rodpauloduran/MAARE-Avionics-System/water_rocket_avionics_bom.xlsx

Sheet: Parts & Costs
Water Pressure Rocket — Avionics Bill of Materials
Prices as shown in the shopping carts on 04 Aug 2026. Stores: Circuit Rocks (Manila) and Makerlab PH (Manila). Shipping and tax not included. Phase 1 = minimum viable flight computer; Phase 2 = full telemetry / research payload.
Category | Item | Store | SKU | Qty | Unit Price | Line Total | Phase | What it does | Why this part | Alternatives / notes | Product Link
Compute | Raspberry Pi Pico (with headers) | Makerlab | — | 1 | ₱459.00 | ₱459.00 | 1 | Flight computer. Runs the sensor loop, state machine and deployment logic. | 264 KB RAM holds the entire 10 s flight in memory, so nothing is written to flash during the 50 g boost. Dual core lets the radio run isolated from the timing-critical sensor loop. | RP2040-Zero (more GPIO, smaller); XIAO RP2040 (lightest). Rejected: ATmega328 Nano (2 KB RAM, cannot buffer a flight) and ESP32 (radio stack causes interrupt jitter). Plain Pico, not W — WiFi is dead weight in the nose and the CYW43 chip takes GP23/24/25/29. | Open product page (https://makerlab.ph/products/raspberry-pi-pico-rp2040-microcontroller-raspberry-pi-pico-w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)
Compute | Raspberry Pi Pico W (ground station) | Makerlab | MLE04027 | 1 | ₱590.00 | ₱590.00 | 2 | Ground station receiver. Takes the LoRa downlink and serves it to your phone over WiFi. | On the ground, mass and pin pressure don't apply, so the WiFi earns its keep: run a soft AP, connect your phone, watch live altitude with no laptop in the field. LoRa sits on SPI0 (GP16–19) so there is no clash with the CYW43 pins. | Heltec WiFi LoRa 32 / TTGO LoRa32 (~₱1,200–1,800) bundles ESP32 + SX1276 + OLED in one board and would replace this plus one RFM95W. NOTE: the with-headers variant (₱575) is sold out; ₱590 is the without-headers price. | Open product page (https://makerlab.ph/products/raspberry-pi-pico-rp2040-microcontroller-raspberry-pi-pico-w-copy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)
Sensor | GY-63 MS5611-01BA03 barometer | Circuit Rocks | AB034 | 1 | ₱421.00 | ₱421.00 | 1 | Primary altimeter and apogee detector. Peak-and-drop logic fires the parachute. | ~10 cm resolution at ~100 Hz. Its two error sources (dynamic pressure and inertial gradient) scale with velocity and acceleration, so both vanish at apogee — exactly where the reading matters. | BMP390 (~5 cm, 200 Hz) is marginally better. BMP280 (~1 m) is flyable with a widened threshold. MPL3115A2 rejected: max ~1–10 Hz gives only 3–30 samples on a 3 s ascent. | Open product page (https://circuit.rocks/products/gy-63-ms5611-01ba03-atmospheric-pressure-module?variant=45812624982305)
Sensor | Pololu MinIMU-9 v6 (LSM6DSO + LIS3MDL) | Circuit Rocks | POL2862 | 1 | ₱2238.00 | ₱2238.00 | 2 | Coast-phase acceleration, gyro attitude, magnetometer heading. Tilt-based apogee backup and flight-path reconstruction. | Gyros are the only source of orientation — no accelerometer can supply it. ±16 g gives fine resolution once boost forces are gone. Proper regulator, level shifting and decoupling, unlike clone boards. | HW-123 / MPU-6050 at ~₱150 is adequate for a 10 s flight and saves ~₱2,100. ICM-42688-P (±4000 dps) is the real fix if the airframe spins past the ±2000 dps ceiling. | Open product page (https://circuit.rocks/products/minimu-9-v6-gyro-accelerometer-and-compass-lsm6dso-and-lis3mdl-carrier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)
Sensor | Adafruit ADXL375 high-g accelerometer ±200 g | Circuit Rocks | 5374 | 1 | ₱2096.00 | ₱2096.00 | 2 | Boost-phase acceleration, launch detection, burnout timing. | The only sensor that does not saturate during the 0.2–0.4 s burn at 20–100 g. Everything else clips at ±16 g and records a flat plateau. | H3LIS331DL (±100/200/400 g) is cheaper with selectable range. Not required for flight 1 — the IMU still detects launch, it just clips. NOTE: ADXL345 is only ±16 g and cannot do this job. | Open product page (https://circuit.rocks/products/adxl375-high-g-accelerometer-200g-with-i2c-and-spi-stemma-qt-qwiic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)
Sensor | SparkFun GPS Breakout SAM-M8Q (u-blox) | Circuit Rocks | GPS-15210 | 1 | ₱2348.00 | ₱2348.00 | 2 | Landing coordinates. A recovery beacon, not a flight sensor — it will lose lock at launch and take 5–15 s to reacquire. | Integrated antenna with u-blox's own RF design removes the commonest silent failure mode. Multi-GNSS including QZSS, which covers the Philippines well. Backup battery gives fast hot starts between flights. | Adafruit Ultimate GPS (GPS-only, 34 s warm start, smaller board, no airborne dynamic model). ZOE-M8Q if the 40×40 mm footprint won't fit the nose cone. | Open product page (https://circuit.rocks/products/gps-breakout-chip-antenna-sam-m8q-sparkfun-force-density-level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)
Radio | Adafruit RFM95W LoRa Breakout 868/915 MHz | Makerlab | — | 2 | ₱1599.00 | ₱3198.00 | 2 | Live telemetry downlink plus post-landing position beacon. One unit flies, one is the ground station. | LoRa spread spectrum buys ~10–20 dB of link budget over FSK — decisive when the rocket lands in wet grass with its antenna horizontal. SX1276 tunes 862–1020 MHz, so frequency is a firmware choice. | RFM69HCW (FSK, ~500 m) if LoRa is out of stock — adequate at your ranges. RFM96W is 433 MHz and will NOT tune to 868 properly. See the Design Notes sheet before setting frequency. | Open product page (https://makerlab.ph/products/adafruit-rfm95w-lora-radio-transceiver-breakout-868-or-915-mhz-radiofruit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)
Recovery | MG90D metal-gear micro servo, 180°, 1.8 kg | Circuit Rocks | AF016 | 1 | ₱192.00 | ₱192.00 | 1 | Pulls the latch pin that releases the nose cone / parachute bay. | Positional (not continuous-rotation) so it moves to a commanded angle and holds. Metal gears survive the 50 g boost and hard landings where plastic gears strip. | SG90 (plastic gears, cheaper, less shock-tolerant). Nichrome burn-wire as an independent backup channel. AVOID the 360° MG90D — it takes speed commands, not angles. | Open product page (https://circuit.rocks/products/micro-servo-mg90d-180-deg-high-torque-metal-gear?variant=45812563247393)
Recovery | LS3040 piezo buzzer (4 kHz, 2 mA) | Makerlab | — | 1 | ₱49.00 | ₱49.00 | 1 | Audible locator on landing; arming and status confirmation on the pad. | 4 kHz sits near peak human hearing sensitivity. 2 mA draw means it can chirp for hours. The cheapest genuinely useful part on the board — it works when the radio doesn't. | Active buzzer module (2.3 kHz, 25 mA, onboard transistor). This unit is active, so no frequency sweep — use chirp patterns instead, which gives most of the localisation benefit. | Open product page (https://makerlab.ph/products/ls3040-piezo-electric-buzzer?variant=43321211748543)
Safety | Reed switch 2×14 mm normally-open (10 pcs) | Circuit Rocks | AL040 | 1 | ₱149.00 | ₱149.00 | 1 | Arming switch. Separates 'powered on' from 'deployment live'. | Sealed inside the airframe, actuated by a magnet from outside — no hole to admit water, nothing protruding to snap off. Prevents the servo firing while your hands are in the bay packing the chute. | Nylon screw switch (latching, visible armed state). Hall effect sensor (no moving parts, immune to vibration) if reeds prove fragile. Pack of 10 because the glass envelope cracks easily. | Open product page (https://circuit.rocks/products/reed-switch?variant=45812587102497)
Safety | Neodymium magnet N35 8×5 mm | Circuit Rocks | 2775 | 1 | ₱15.00 | ₱15.00 | 1 | Actuates the reed switch through the nose cone wall. | Comfortably strong enough to close a 14 mm reed at a few centimetres through plastic. Tape it in place to arm; peel it off to disarm on recovery. | Any N35+ neodymium of similar size. Keep it well away from the LIS3MDL magnetometer and the LiPo. | Open product page (https://circuit.rocks/products/magnet-neodymium-n35-ndfeb-circular-8x5mm?variant=45837630570785)
Power | PKCell 500 mAh LiPo 3.7 V (LP503035) | Makerlab | — | 1 | ₱200.00 | ₱200.00 | 1 | Powers the flight computer. Feeds Pico VSYS directly, no regulator needed. | ~5 h runtime at ~100 mA draw, and only 10.5 g. Integrated protection circuitry (over-charge, over-discharge, short). Genuine JST-PH connector. | Rejected: 2×18650 (~90 g, 30 h runtime, needs a buck converter) — 15× the energy at 12× the mass, and nose mass directly costs apogee. Hard-mount in foam; never let it float loose. | Open product page (https://makerlab.ph/products/lithium-ion-polymer-battery-3-7v-500mah?variant=42292840956095)
Power | Adafruit Micro LiPo Charger (MCP73831, micro-USB) | Circuit Rocks | 1904 | 1 | ₱662.00 | ₱662.00 | 1 | Charges the flight battery off any USB port. | Jumper-selectable 100/500 mA — set 500 mA for exactly 1 C on this cell, with no SMD resistor surgery. JST-PH connector already fitted, so it mates with the battery directly and there is no polarity risk. | TP4056 module (~₱60) is far cheaper but ships at 1 A and needs its R_prog resistor swapped from 1.2 kΩ to 2.4 kΩ, plus a soldered JST pigtail. Take the USB-C variant if stocked. | Open product page (https://circuit.rocks/products/micro-lipo-with-microusb-jack-usb-liion-or-lipoly-charger-v1-adafruit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)
Power | Capacitor electrolytic 220 µF 16 V (10 pcs) | Circuit Rocks | 2192 | 1 | ₱25.00 | ₱25.00 | 1 | Bulk decoupling at the servo power pins and at the LoRa module. | Servo inrush and LoRa transmit spikes are the classic cause of mysterious Pico resets and brownouts mid-flight. | Any 220–470 µF, ≥10 V. Also add 100 nF ceramics at each IC — not yet in either cart. | Open product page (https://circuit.rocks/products/capacitors-electrolytic-220uf-16v-pack-of-10?variant=45813709013281)
Power | Resistor 100 kΩ 5% 1/4 W (10 pcs) | Circuit Rocks | 2787 | 1 | ₱19.00 | ₱19.00 | 1 | 2:1 divider for battery voltage telemetry into GP26 (ADC). | Lets the LoRa packet report battery voltage, so you know the rocket is healthy before pressurising to 120 psi. | Any matched pair from 10 kΩ to 100 kΩ. Higher values draw less standby current. | Open product page (https://circuit.rocks/products/resistors-through-hole-100k-ohm-5-1-4w-pack-of-25?variant=45813708685601)
Build | FR4 universal protoboard, double-sided, 5×7 cm | Makerlab | — | 2 | ₱12.50 | ₱25.00 | 1 | Flight avionics stack — two decks joined by M3 nylon standoffs. | FR4 with plated-through holes, NOT phenolic/bakelite: phenolic pads lift off under 50 g shock. Two 5×7 decks fit a tapering nose cone far better than one 7×9 slab. | Lower deck: Pico, power, MOSFET, buzzer, servo header. Upper deck: sensors, GPS antenna facing up, LoRa antenna routed away from the GPS. | Open product page (https://makerlab.ph/products/fr4-universal-protoboard-pcb-double-sided?variant=43922032099519)
Build | FR4 universal protoboard, double-sided, 6×8 cm | Makerlab | — | 2 | ₱17.50 | ₱35.00 | 1 | Ground station board (receiver Pico + LoRa + optional OLED). | Mass and size are irrelevant on the ground, so the larger board gives easier layout. | Buy spares of both sizes — you will botch a layout at least once and want to redo it. | Open product page (https://makerlab.ph/products/fr4-universal-protoboard-pcb-double-sided?variant=43922032132287)
Build | Breadboard 400 tie-point | Circuit Rocks | AJ329 | 2 | ₱45.00 | ₱90.00 | 1 | Bench prototyping before anything is soldered. | One 400-point board holds a Pico and roughly one breakout. Five modules need two boards minimum. | An 830-point board is a better single purchase. Bring devices up ONE at a time and run an I2C scanner after each addition. | Open product page (https://circuit.rocks/products/breadboard-400-tie-point-interlocking-solderless-crystal?variant=45812706607393)
Build | 40-pin jumper wires, 20 cm male-male | Makerlab | — | 1 | ₱59.00 | ₱59.00 | 1 | Breadboard interconnects. | Standard prototyping consumable. | Solid-core 22 AWG hookup wire gives much cleaner, shorter runs — worth having for debugging. | Open product page (https://makerlab.ph/products/40-pin-10cm-jumper-wires?variant=43922163400895)
Build | 40-pin jumper wires, 20 cm male-female | Makerlab | — | 1 | ₱59.00 | ₱59.00 | 1 | Connecting modules that end up with female headers. | You need both genders; several breakouts ship headers loose so the choice is yours at soldering time. | — | Open product page (https://makerlab.ph/products/40-pin-10cm-jumper-wires?variant=43922163368127)
Power | Adafruit JST-PH switched 2-pin SMT right-angle (1863) | Circuit Rocks | 1863 | 1 | ₱215.00 | ₱215.00 | 1 | Battery connector AND power switch in one part. The LiPo plugs in; a slide switch cuts the output. | Solves two problems with one 2 g part and no hole in the airframe. Right-angle SMT keeps it low-profile on the lower deck, and the switch is inboard so nothing protrudes to snap off or admit water. | This replaces the need for a separate panel-mount power switch on the rocket. Alternative: no power switch at all — unplugging the JST is a perfectly good disconnect. | Open product page (https://circuit.rocks/products/jst-ph-switched-2-pin-smt-right-angle-breakout-board?variant=45813701017889)
Power | JST-PH 2.0 mm 2-pin female cable, 100 mm 26 AWG (10 pcs) | Makerlab | MLE07290 | 1 | ₱50.00 | ₱50.00 | 1 | Pigtails for wiring the battery into the flight board and for bench test leads. | 2.0 mm PH pitch — matches the PKCell battery and the Adafruit charger. 26 AWG is good for ~2 A, well past the 700 mA servo spike. | Do NOT buy JST RCY: it is 2.5 mm pitch and will not mate. Meter the pigtail against the battery before soldering — cheap cables occasionally have red/black swapped relative to the housing key. | Open product page (https://makerlab.ph/products/10-pcs-2-pin-jst-ph-female-connector-cable-100mm-26awg?variant=44313735725247)
Power | JST-PH 2.0 mm 2-pin angled shrouded male header (25 pcs) | Makerlab | MLE07362 | 1 | ₱99.00 | ₱99.00 | 1 | Board-mount sockets on the protoboard for the battery and any other detachable subassembly. | Right-angle keeps the connector flat against the deck instead of standing proud. Shrouded housing is polarised, so reverse-polarity insertion is physically impossible. | 25 pieces is far more than this build needs, but it makes every future project's battery connector free. | Open product page (https://makerlab.ph/products/25pcs-2-pin-angled-jst-ph-shrouded-male-connector-1?variant=44349686939839)
Build | Solder wire 0.6 mm 63/37 rosin core | Circuit Rocks | TOL-10242 | 1 | ₱271.00 | ₱271.00 | 1 | Soldering headers onto every breakout, plus all board wiring. | 0.6 mm is the right size for through-hole header work — feeds fast enough not to overheat pads, fine enough for occasional SMD. 63/37 is eutectic: no plastic phase, so fewer cold joints while learning. | 0.4 mm is SMD-focused and tedious on header pins; 1.0 mm bridges adjacent pins. Rejected both. Set the iron to ~330 °C. Buy a flux pen separately — it makes header joints dramatically easier. | Open product page (https://circuit.rocks/products/solder-wire-0-5mm?variant=45816082727201)
Build | Mini panel-mount SPDT toggle switch | Circuit Rocks | 3221 | 1 | ₱25.00 | ₱25.00 | 2 | Power switch for the ground station field box. | Latching SPDT, rated far beyond the ~100 mA load. On a table-mounted receiver its 5 g mass and 6 mm hole are irrelevant, and a physical toggle is what you want for power. | Deliberately NOT used on the rocket: 5 g, 33 mm long, and a 6 mm hole in an airframe that lands in wet grass. The switched JST breakout handles rocket power instead. | Open product page (https://circuit.rocks/products/toggle-switch-mini-panel-mount-spdt?variant=45812674593057)
Build | 40-pin jumper wires, 20 cm (third variant) | Makerlab | — | 1 | ₱59.00 | ₱59.00 | 1 | Third gender of jumper wire — likely female-female, confirm the variant at checkout. | Completes the set so any module-to-module or module-to-breadboard connection is possible without improvising. | Verify which gender this variant is before ordering; the product slug is shared across all three. | Open product page (https://makerlab.ph/products/40-pin-10cm-jumper-wires?variant=43922163335359)
 | GRAND TOTAL (both stores) |  |  |  |  | ₱13648.00
 | Circuit Rocks subtotal |  |  |  |  | ₱8766.00
 | Makerlab subtotal |  |  |  |  | ₱4882.00
 | Phase 1 subtotal — minimum viable flight computer |  |  |  |  | ₱3153.00
 | Phase 2 subtotal — GPS, IMU, high-g accel, LoRa pair |  |  |  |  | ₱10495.00
 | ASSUMPTION: the Makerlab cart displays a ₱25.00 / ₱35.00 unit price for the two protoboard sizes but a line total of ₱25.00 / ₱35.00 at qty 2. Unit price is entered here as ₱12.50 / ₱17.50 so the sheet reconciles with the ₱4,543.00 subtotal shown in the cart. Verify at checkout — this may be a cart display bug.
 | Blue cells are hardcoded inputs (prices copied from the carts, 04 Aug 2026). Black cells are formulas.

Sheet: Store Summary
Cost by Store
Calculated totals cross-checked against the subtotals displayed in each shopping cart.
Store | Location / terms | Units | Current Subtotal | Original Cart (04 Aug) | Added Since
Circuit Rocks (https://circuit.rocks/collections/all) | Manila — same-day ship before 4 PM; free shipping unlocked | 15 | ₱8766.00 | ₱8255.00 | ₱511.00
Makerlab (https://makerlab.ph/) | Makerlab Manila — tax included, shipping at checkout | 15 | ₱4882.00 | ₱4543.00 | ₱339.00
TOTAL |  | 30 | ₱13648.00 | ₱12798.00 | ₱850.00
'Original Cart (04 Aug)' is the subtotal each cart displayed before this revision (Circuit Rocks ₱8,255.00; Makerlab ₱4,543.00). 'Added Since' is the net change from dropping the second plain Pico and adding the Pico W, JST-PH connectors, switched battery breakout, SPDT toggle, solder wire and the third jumper variant. Neither figure includes shipping.

Sheet: Phasing
Build Phasing — Risk vs Cost
Water rocket recovery fails often on early flights. Flying a cheap configuration first proves the airframe, chute packing and deployment mechanism before expensive sensors are exposed to a hard landing.
Phase | Contents | Cost | % of Total | Rationale
Phase 1 | Pico ×2, MS5611 barometer, servo, buzzer, reed switch + magnet, LiPo + charger, passives, protoboard, breadboards, jumper wires | ₱3153.00 | 23.1% | Everything needed to log altitude and deploy a parachute reliably. Baro-primary apogee detection with a timer backup is competitive on a 3 s ascent. Fly this 3–4 times first.
Phase 2 | SAM-M8Q GPS, Pololu MinIMU-9 v6, ADXL375 high-g accelerometer, RFM95W LoRa ×2 | ₱10495.00 | 76.9% | Research payload: boost-phase g data, attitude reconstruction, live telemetry, GPS recovery. Add these to a vehicle whose recovery you already trust.
TOTAL |  | ₱13648.00 | 100.0%

Sheet: Still Needed
Not Yet in Either Cart
Estimated Philippine street prices entered as blue placeholders — replace with real quotes. Some of these are tools you may already own.
Item | Category | Est. Cost | Why it's needed
Multimeter | Tool | ₱500.00 | The single most important tool. Continuity checking alone saves hours; verify LiPo polarity before connecting anything.
Soldering iron, temperature-controlled | Tool | ₱1200.00 | Every breakout ships with headers loose in the bag. Soldering is not optional. Set to ~330 C for the 63/37 solder already in the cart.
Flux pen or paste | Tool | ₱200.00 | Rosin-core solder has flux inside, but extra flux on the pad is what makes header joints suddenly feel easy. Essential for any rework.
Solder wick, brass tip cleaner, helping hands | Tool | ₱400.00 | Rework and cleanup. You will make bad joints while learning.
USB logic analyzer, 8-channel clone (Sigrok/PulseView) | Tool | ₱450.00 | Highest-value cheap debug tool for I2C. When the bus goes silent you will see exactly why.
Data-capable USB cable for the Pico | Tool | ₱150.00 | Half the cables in any drawer are charge-only. This wastes a surprising amount of time.
100 nF ceramic capacitors (assortment) | Passive | ₱100.00 | Decoupling at every IC, alongside the 220 uF bulk caps already in the cart.
M3 nylon standoffs 15-20 mm + screws | Mechanical | ₱150.00 | Join the two avionics decks. Nylon not metal — lighter, and no accidental shorts.
EVA foam sheet / soft silicone potting | Mechanical | ₱200.00 | Shock isolation. A rigidly bolted PCB transmits the full 50 g spike; foam does not.
Piano wire 1 mm + servo horn hardware | Mechanical | ₱150.00 | The latch pin itself. Test the pull with the chute actually packed — friction is far higher than a bare bench test.
Solid-core hookup wire 22 AWG | Build | ₱200.00 | Clean short runs on the flight board. Jumper wires everywhere makes debugging miserable.
Antenna wire for 82 mm quarter-wave | Radio | ₱50.00 | 82 mm at 868 MHz (78 mm at 915). Cut accurately — wrong antenna length costs more range than any power setting.
SMA whip antenna + pigtail for ground station | Radio | ₱400.00 | A proper antenna on the receiver roughly doubles usable range for a few hundred pesos.
Conformal coating or clear nail polish | Mechanical | ₱150.00 | The rocket lands wet. Coat the board; leave the barometer port and exposed sensor dies uncovered.
LiPo safety bag or ceramic tile | Safety | ₱250.00 | Charge on a non-flammable surface, never unattended. Cheap insurance.
Gore-Tex or hydrophobic mesh scrap | Mechanical | ₱100.00 | Covers the static ports. A water droplet across a port gives wildly wrong pressure readings.
ESTIMATED ADDITIONAL SPEND |  | ₱4650.00
ASSUMPTION: every cost on this sheet is a rough estimate supplied as a placeholder, not a quote. They are shown in blue as hardcoded inputs — overwrite them with real prices.

Sheet: Design Notes
Key Design Decisions & Regulatory Notes
The reasoning behind the parts chosen, and the constraints that drove them.
Topic | Decision | Reasoning
Apogee detection | Barometer peak-and-drop is primary. Timer is backup. IMU tilt is an inhibit only. | Baro differentiates a measured position — error is bounded and never accumulates. An IMU integrates acceleration — error is unbounded, grows from a clipped boost, and is undetectable without an external reference. Baro error sources (dynamic pressure ~ v², inertial gradient ~ a) both vanish at apogee.
Detection latency | MS5611 at ~10 cm noise needs ~30 cm of drop ≈ 0.25 s past apogee. A BMP280 at ~1 m would need ~0.7 s. | Altitude near apogee follows h = h_max − ½gt², so the curve is flat there and sensor noise translates directly into detection delay. This is the entire argument for the MS5611 over the cheaper BMP280.
Deployment lockout | Inhibit deployment until boost has ended plus ~0.5 s. Latch the fire flag so it cannot retrigger. | Prevents a boost-phase pressure transient firing the chute at 70 m/s. Bias every threshold toward late — late deployment costs some data, early deployment shreds the parachute.
Static ports | 3–4 holes of ~1 mm, evenly spaced, at least one body-diameter aft of the nose shoulder. | Uneven or badly placed ports cause pressure asymmetry that reads as phantom altitude. Port quality dominates sensor noise if you get it wrong. Size for lag too — keep the bay time constant under ~50 ms.
I2C bus | MS5611 (0x77), LSM6DSO (0x6A), LIS3MDL (0x1C/0x1E), ADXL375 (0x53), GPS (0x42) — all on two wires. | No address conflicts. Run at 400 kHz with short traces. Watch for clone boards carrying 2.2 kΩ pull-ups; three in parallel is too strong and the bus will misbehave.
Firmware architecture | Core 0: 500 Hz sensor loop and state machine, buffered in RAM. Core 1: LoRa TX, GPS parsing, flash dump after landing. | No flash writes during the 50 g boost — the commonest way to lose a flight's data. If the radio stalls, core 1 stalls and core 0 never notices. Deployment logic must never depend on the link.
Filtering | Log raw counts in flight. Do Kalman fusion offline in Python. | Iterate in seconds instead of reflashing and relaunching. Port the filter onboard only once it agrees with raw data across a dozen flights.
LoRa frequency — CHECK THIS | Configure to 868–870 MHz at +14 dBm, NOT the US 915 default. Verify current NTC rules yourself before flying. | NTC MC 03-06-2017 lists PH non-specific SRD / telemetry bands as 868.000–868.600, 868.700–869.200 and 869.300–869.700 (25 mW erp), plus 869.700–870.000 (5 mW erp). Whether 915–918 (AS923-3) is permitted is actively disputed in the LoRa community. NTC MC 004-06-2026 amended SRD parameters again in June 2026 — check for anything newer.
LoRa duty cycle | EU-style bands typically carry a 1% duty cycle limit. | At SF7/BW250 a 16-byte packet is ~10 ms airtime, so 20 Hz telemetry is ~20% duty. Either slow the live stream toward ~1 Hz, or accept the tradeoff knowingly. A landed beacon at one packet per 5 s is comfortably within limits.
Mass budget | ~80 g total avionics, all of it in the nose cone. | A water rocket has fixed impulse from its pressure vessel, so every gram of dry mass directly costs apogee. Nose mass also shifts CG forward, requiring larger fins to keep CP aft of it.
Arming sequence | Battery in → pack chute → seat cone → mount on launcher → ARM with magnet → step back → pressurise. | Arming is the last action, performed from outside a sealed airframe. Disarming is the first action on recovery, before touching the rocket. A buzzer chirp and a state field in the LoRa packet confirm it from 10 m away.
