rodpauloduran/MAARE-Avionics-System/CHANGELOG.md

# Changelog

Notable changes to the MAARE avionics system, newest first.

Format loosely follows [Keep a Changelog](https://keepachangelog.com/).

---

## [0.3.2] — 2026-09-13

Four things the v0.3.1 notes listed as unresolved, the outdoor GPS test that
had been open since v0.2.0, and three of the four long-standing bench items.

### Added

- **`!hgcal` — a six-position ADXL375 zero-g offset trim.** The part has
  hardware offset registers (`OFSX`/`OFSY`/`OFSZ`) applied before the data
  reaches the output registers; the Adafruit library does not expose them but
  does expose `writeRegister()`. Rest the board on each of its six faces and
  capture one at a time, and gravity cancels out of each axis's up/down
  average, leaving the bias. `apply` **adds** its correction to whatever is
  already in the register, having measured the residual with that value
  applied — so the datasheet's 196 mg/LSB is a starting guess rather than a
  dependency, and a second pass squares away however wrong it is. Not
  persistent: it prints three `HG_TRIM_*` constants to paste and re-flash,
  applied and read back at boot like every other setting. Drivable from a phone
  (`hgcal zup`), since the calibration wants both hands on the board.
- **The I²C scan measures the `0x7E` phantom instead of mentioning it.** Every
  address is probed eight times at 100 kHz and again at 400 kHz, with the hit
  rate printed beside it. 8/8 at both speeds is a device; intermittent, or
  present only at 400 kHz, is the master reading a floating line as an
  acknowledgement — and the scan now says so, along with what to change. No
  firmware can repair a marginal bus; it can stop reporting one pass as a fact.
  Bus speed is explicit (`I2C_HZ`) rather than the core's implicit default.
- **Latch feedback, the firmware half.** Set `LATCH_SWITCH_PIN` and every
  commanded move is confirmed against the switch after the settle window, with
  a failure printing `*** LATCH DID NOT RELEASE ***` and sounding the alarm.
  The sensed state rides in telemetry as a new `lsw` field — the only measured
  field in that line. The polarity is deliberate: closed to ground when
  released, pulled up, so a broken wire reports a fire that did not happen
  rather than certifying one that did.

### Changed

- **Nothing claims the latch fired when all it knows is that it asked.** With
  no switch fitted the board logs `SERVO FIRE COMMANDED ... (no feedback - not
  confirmed)` and the viewer reads `latch: FIRE COMMANDED (unconfirmed)`. With
  one fitted it reads `RELEASE CONFIRMED`, or `FIRED BUT STILL ENGAGED`.
- **The viewer says less.** The deployment panel's standing explanation — why
  the harness is not the flight path, the section references, the argument for
  keeping deployment on the board — is eleven lines shorter and now carries
  only what changes an action: keep hands clear while ARMED, and arming lapses
  3 s after the page stops sending heartbeats. Tooltips, the trajectory legend
  and the connection banners are trimmed the same way. The reasoning was
  already in the documentation, which is where it belongs.

### Fixed

- **The ground station now forwards every frame, once, instead of resending
  the latest one on a timer.** Each frame carries a sequence number and each
  connected browser tracks which one it has been sent — the same rule board
  messages already used. Before this, a stream slept one frame period and sent
  whatever `latest` held, so delivery was capped at the station's own loop
  period (`FRAME_DT` plus the time to write) and the frames produced in between
  were never sent at all: a 25 Hz board arrived at the 23 Hz visible in the
  v0.3.1 screenshots, and a 50 Hz radio would have been halved. A browser that
  cannot keep up still drops frames rather than queueing them — it is sent the
  frame that stands now, never a backlog.
- **The 5-second diagnostics summary no longer floods a phone's console.** Its
  GPS line went through `Out`, which tees to the wired link, so with no USB
  host attached the board stayed in table mode and pushed one of these to every
  phone every 5 seconds, burying the acknowledgements and refusals that are the
  console's job. `printGpsStatus()` now takes its destination from the caller:
  the link for `g` and `!g`, which someone asked for; USB only for the summary,
  which nobody did.
- **The stage label no longer runs underneath the stage tabs on a phone.** The
  label and the tabs were independent overlays pinned to opposite corners of
  the same strip, which collides as soon as the label is long and the screen is
  narrow — `Trajectory — altitude measured, horizontal from GPS` sat directly
  under the tab row. They now share one flex container: side by side with room,
  stacked when not, tabs on top.
- **Deployment condition rows no longer come apart when they wrap.** Two 104 px
  value spans and a 74 px number input cannot share a 360 px screen, so the
  controls spilled one per line and the remove button ended up alone on a row
  of its own. Narrow screens now lay each row out as a grid with a named place
  for every control.
- **Constants wrapped over two lines were silently dropped from the test
  extract**, which surfaced as the ground-station model failing to compile
  rather than as anything to do with line length. The extractor now carries
  continuation lines with the assignment that opens them.

### Confirmed on hardware

- **Commands from a phone act on the board.** The one thing v0.3.1 shipped
  without evidence for.
- **The GPS, outdoors.** 12 satellites at ±2.5 m, tracking a path walked on
  foot 245 m from the pad datum — against the 5 satellites and 238 m wander
  that an indoor sky view gave, and matching what §4.5 predicted. Every fix in
  that track cleared the ±10 m pad-datum gate, so the path drew solid for its
  whole length. The receiver, its antenna and the configuration are sound; the
  remaining error is metres, which is why GPS stays a recovery aid and never a
  deployment input.

- **Stream forwarding is now testable.** The rule lives in a `StreamCursor`
  object rather than inline in `serve_stream`, so `run_checks.py` can drive it
  with a fake clock and no socket: every frame forwarded once per browser, the
  current frame rather than a backlog to a slow client, independent clients,
  keep-alive comments paced rather than one per poll, and the first frame after
  a silence sent even when identical to the last one before it. The old
  behaviour was wrong in a way nothing could see, because there was nothing to
  call. Mutation-tested — restoring either the v0.3.1 resend or a queueing
  variant fails the run.

### Docs

- **Outdoor GPS screenshots** in the README, §4.5 and the status report; the
  open item asking for them is closed, and the indoor-only qualification is
  gone from the design doc's summary.

### Known, unresolved

The three bench items above all now have their firmware half; what is left is
bench work and one part.

- **`!hgcal` has not been run on the hardware.** Until it is and the three
  `HG_TRIM_*` constants are committed, the ADXL375 still reads 0.73 g at rest
  against the LSM6's 1.01 g.
- **The `0x7E` phantom has not been re-measured** with the new two-speed scan,
  so whether it is intermittent, rise-time dependent, or stubbornly 8/8 at both
  speeds is still unknown.
- **No limit switch is fitted**, so no latch movement is confirmed by anything
  physical. The firmware is waiting on `LATCH_SWITCH_PIN`.
- **The latch-feedback and calibration paths are untested on hardware.**
  Everything compiles and the offset arithmetic is straightforward, but no
  switch has ever closed and no trim register has ever been written outside a
  compiler.
- **The servo stays on VBUS** by choice — the power bank lives on the flight
  Pico, so VBUS is present.
- **The ground station stays on its default Wi-Fi password** by choice; it is
  published in this repository, and that network can arm the latch.

## [0.3.1] — 2026-09-11

### Added

- **Wired UART downlink, as a stand-in for the radio** while the antenna
  pigtails and connectors are not on hand. The flight computer writes the §6.6
  line to `Serial1` (GP0) every tick, whatever its USB port is doing; the
  ground station reads GP1 into the same producer slot the radio will use. It
  tests everything downstream of the receiver and nothing about the receiver.
  **Transmit-only from the flight side**, deliberately: the real link is
  fire-and-forget, and a wire that could arm the latch from the ground is not a
  decision to make by accident in a test rig.
- **Explicit telemetry sources on the ground station** — `uart` (default) or a
  synthetic profile — with **no fallback** from a dead wire to synthetic data.
  In `uart` mode the synthetic model does not run, so a quiet wire goes stale
  instead of being papered over. `/health` reports the source and link counters
  in every mode.
- **Frame validation and line reassembly on the station** (`feed()`,
  `accept_line()`): partial lines, board text, undecodable bytes and wrong
  field counts are counted and dropped before they reach a browser.

- **Full control from a phone** — board commands and the whole deployment
  panel, served by the ground station and relayed up the wired link. The wire
  was built transmit-only first so that ground control of the latch could not
  arrive by accident; this adds it on purpose, with the constraints that make
  it tolerable:
  - `/cmd` **rebuilds every command from an allowlist** rather than forwarding
    it; unknown words, extra arguments, out-of-range numbers and a second
    command smuggled after an encoded newline are refused.
  - The flight computer accepts **framed `!word` lines only** from the wire,
    never a bare byte — so noise on an unplugged RX pin cannot trigger `z` or
    `b`. `v`, `c` and `h` have no framed form and cannot be sent up at all.
    Over-long lines are discarded rather than acted on as a truncated prefix.
  - **Board commands are refused unless the wire is the selected source**, at
    the station (`409`) and in the page (buttons greyed, an armed latch told to
    safe), because a real latch beside a synthetic display is a display lying.
  - **The deadman is unchanged**: heartbeats come from the page, so locking the
    phone or switching apps disarms the latch within 3 s.
- **Board messages reach the phone.** Everything the flight computer says about
  its state — acknowledgements, refusals, the boot banner, GPS status — is
  teed to the wire as `M,` lines and fanned out to every phone's console as SSE
  `msg` events, with recent ones replayed to a phone that joins late.
- **`station_secret.py`** for the Wi-Fi password, git-ignored. Joining the
  network now means being able to arm the latch, and the default is public; the
  station warns at boot and in `/health` while it is still in use.
- **`tools/checks/viewer_net_checks.js`** — the viewer loaded as the station
  serves it, over HTTP with fake `fetch` and `EventSource`, checking command
  routing, refusals, board messages, and that controls die and an armed latch
  is safed when the source goes synthetic. Mutation-tested: removing either the
  source guard or the network routing makes it fail.

### Fixed

- **The viewer read `Live` the moment the SSE connection opened**, before any
  data. With the wire as the default source and nothing on it, that meant LIVE
  over a motionless model — the exact confusion the staleness work exists to
  prevent. `Live` now waits for the first real frame.
- **The source selector and hint asserted a source instead of reading one.**
  The selector always opened on "Bench wobble" and the hint always said
  "synthetic". Both now come from `/health`.
- **§6.5's diagram had the RFM95W talking to the Pico W over UART.** It is an
  SPI transceiver. Corrected, along with the open item that described the
  eventual radio producer as a UART reader.
- The ground station README's copy of the wire format was missing v0.3's
  `srv,srvus` fields.

### Notes

- **`Serial1.write()` blocks on this core** (`mbed::UnbufferedSerial`,
  busy-waiting on `writeable()` past the 32-byte FIFO). The link runs at
  **460800** baud so a ~100-byte line costs the flight loop ~1.5 ms rather than
  ~6 ms at 115200.
- **Wiring:** GP0↔GP1 both ways and GND→GND between the boards. Power either
  each board from its own USB, or one power bank with VSYS joined to VSYS —
  and in the latter case **move the servo's V+ from VBUS to VSYS**, because
  VBUS only exists on a board whose own USB is plugged in. 3V3_EN is the
  regulator's enable input, not a supply — tying it anywhere powers nothing and
  can switch a board off.

### Known, unresolved

- **Commands sent from a phone have not yet been seen to act on the board.**
  The phone screenshots confirm the downlink on hardware: live telemetry at
  23 Hz on the board's clock with zero bad lines, the source read correctly from
  the station, the latch state reported by the board, and the board's messages
  reaching the phone's console. They do not show an `arm` or `fire` from the
  phone producing `SERVO ARMED` or moving the horn.
- **The station forwards at most its own loop rate, not every frame.** It
  resends "the latest frame" on a fixed timer rather than forwarding each new
  one, so its loop period — `FRAME_DT` plus the time to write — caps delivery,
  and frames the board produced in between are never sent. The 23 Hz in the
  phone screenshot is that cap showing. The fix is to forward each new frame
  once, by sequence number, the way board messages already are.
- **Phone layout:** the stage label runs underneath the stage tabs on a narrow
  screen, and a deployment condition row wraps so its `×` button stretches the
  full width.
- **The phone console fills with a GPS line every 5 s** when the flight
  computer has no USB host. With nobody on its USB port it stays in table mode,
  and its 5-second summary's GPS status is teed to the wire along with the
  messages that matter. The summary should go to USB only.

### Docs

- **Phone screenshots and bench photographs of the wired rig**, in the
  README, §6.5, the hardware reference and the ground station README.
- **Photographs refreshed for v0.3**, and a new `viewer-trajectory.png`. The
  attitude screenshot now shows the deployment panel and serial monitor
  expanded, with the board's own log of a fire; the boot output shows the buzzer
  and servo latch announcing themselves silent and safe; the bench photos show
  the MG90D, the LS3040 and an RFM95W breakout alongside the sensors.
- **Captions rewritten to match**, because every one quoted figures from the
  screenshot it replaced. `bench-stack-2` moved from the §4.1 address map to
  the §8.1 latch section, since it now shows the servo and buzzer rather than
  the sensors, and `bench-stack-1` took its place in §4.1.
- **Release-note images pinned to their tags.** The v0.2.0 and v0.2.1 notes
  embedded their screenshots from `main`, so refreshing the photos silently
  changed what those older release pages showed — the v0.2.1 page would have
  displayed a v0.3 interface. Each now points at the image as it was at its own
  tag.

---

## [0.3.0] — 2026-09-11

### Added

**MG90D servo latch on GP6, with a configurable trigger harness in the viewer.**

- **Firmware.** The latch is driven through the **Servo** library. New `!`
  prefixed line commands carry the values a single character cannot:
  `!arm`, `!safe`, `!fire`, `!latch`, `!us <n>`, `!pos <a> <b>`, `!srv`, `!hb`.
  The existing single-character commands are untouched and still dispatch on
  arrival, so a truncated line can never be mistaken for one.
- **Wire format** gained `srv` and `srvus` — appended, so 8/9-field parsers are
  still unaffected. The viewer shows the **board's** view of the latch, not its
  own belief; if the two disagree, that is the thing worth seeing.
- **Viewer panel** (collapsed by default, because it is an actuator control):
  arm/safe, manual fire and re-latch, endpoint calibration in microseconds, and
  an editable condition list — altitude, drop below peak, vertical velocity,
  tilt, |a|, high-g, rate magnitude, satellites, time since arm — each with a
  comparator and threshold, combined with **all** or **any**, and a **sustain
  window** the conditions must hold before firing. Settings persist across
  reloads. **Export** emits the tuned values as C constants.

**Interlocks**, in the order they matter: the pin is **not driven at boot**
(period set, pulse width zero); nothing moves while disarmed, and arming does
not itself move anything; a **3 s deadman on the board** disarms if the host
goes quiet; firing latches and auto-safes, and the viewer also disarms on
telemetry staleness or a closed port.

> **This is a bench harness, not the flight deployment path.** Conditions are
> evaluated in the browser and a fire command is sent down the wire — the right
> shape for a bench rig, and exactly the wrong shape for flight, where
> deployment must live in the board's state machine and never depend on a link
> (§2.3, §5.4). The harness produces *numbers*; those are what get compiled
> into the flight firmware.

- **LS3040 buzzer on GP7**, with non-blocking pattern playback — chirp, double,
  locator, alarm — selectable from the viewer, plus `!beep <hz> <ms>` for a
  one-shot. Arming the latch chirps and firing it double-beeps, which is
  §8.5's arming confirmation made audible. The board owns the timing, so a
  backgrounded browser tab cannot silence the locator.
- **Pin map reconciled again:** §9.1 specified the buzzer on GP13; it is on
  **GP7**. GP13 returns to the free list.

### Fixed

- **`tone()` leaks on this core, so the buzzer does not use it.**
  `Tone::stop()` nulls the `DigitalOut` *pointer* instead of writing the pin
  low, so `delete pin` frees nothing and every call leaks one `DigitalOut` —
  and the pin can be left HIGH, putting DC across a piezo after the beep.
  The buzzer drives a `DigitalOut` from a `Ticker` directly, allocated once.
- **Fire, and every condition-triggered fire, did nothing** — while `Go
  latched`, `Go released` and `Re-latch` all worked. The viewer sends `!fire`
  and then `!safe` back to back, as an interlock against a test rig staying hot.
  But `!safe` detached the servo a millisecond after `!fire` wrote the released
  position, cutting the pulse train before the horn could travel. The commands
  that worked were exactly the ones that leave the servo attached. Fixed on the
  board: safe refuses new motion immediately, but lets an already-commanded
  move finish over an **800 ms settle window** before stopping the pulse train.
  The interlock had been defeating the action it guarded.
- **The viewer no longer fires into a latch the board reports as already
  fired.** The board keeps `fired` latched until an explicit re-latch, as with
  `deployFired` in §5.4, so a second fire only earned a silent refusal. The
  condition engine now holds off, and the verdict says to re-latch first.
- **The servo did not move — because the servo was faulty.** A replacement
  moved under both a raw bit-bang and the Servo library, on VBUS, on the first
  try. Along the way the latch moved from `mbed::PwmOut` to the **Servo**
  library, which is confirmed working and stays. Attach/detach now serve as the
  arm/safe states, a stronger guarantee than a zero pulse width: detached, no
  pulse train exists at all.

  **Withdrawn:** an earlier entry here claimed `PwmOut` "compiles on this core
  and does not drive the pin", and cited the Servo library and `tone()` both
  avoiding it as evidence. Neither holds. `PwmOut` was only ever tried against
  the faulty servo, so it is *untested*; and a library's choice of mechanism is
  not evidence about a peripheral — software timing works on any pin, which is
  reason enough. Kept on the record rather than deleted, because a dead
  actuator making working firmware look broken is exactly the kind of silent
  failure this project exists to catch, and it caught this one late.
- **Added `servo_smoke/`** — one pin, one servo, no sensors or logic — so a
  stationary latch can be separated into firmware versus wiring and power in a
  single flash.
- **The design document claimed the Mbed core bundles a Servo library. It does
  not.** Verified against core 4.6.0, whose entire bundled set is MRI, PDM, SPI,
  Scheduler, ThreadDebug, USBHID, USBMSD and Wire. Corrected in §9.2 and the
  hardware reference, with the Library Manager install documented in its place.
- **Pin map reconciled to as-built.** §9.1 specified the servo on GP15; it is on
  **GP6**. Both documents now say GP6, and GP15 returns to the free list.

### Known, unresolved

- **The Fire path has not been confirmed on hardware.** The early-detach bug is
  fixed and the firmware compiles; the viewer's firing logic passes the
  headless checks. But the servo has not yet been *seen* to swing on `Fire` or
  on a condition-triggered fire since the fix. `Go latched`, `Go released` and
  `Re-latch` are confirmed. Treat conditional firing as unverified until it has
  been watched.
- **`mbed::PwmOut` is untested on this core**, not known-broken — see above.
- **VBUS is marginal for this servo on paper**, though it works in practice:
  USB 5 V behind a Schottky is roughly 4.7 V, against an MG90D specified from
  4.8 V, and a USB port current-limits near the servo's ~700 mA stall. Fine for
  an unloaded bench latch; re-check under a packed chute, and give it its own
  supply for flight.
- **A servo has no readback, and this project's standing rule cannot be applied
  to it.** `srvus` is what was *commanded*, never what the horn did — a stalled,
  stripped or unpowered servo reports exactly the same as a healthy one. The
  honest fix is mechanical: a limit or reed switch confirming the pin withdrew.
  Until then, "fired" means "commanded to fire".
- The latch has not been run on its own supply with the 220 µF fitted.

---

## [0.2.1] — 2026-09-09

### Added

- **`Fix gate` toggle** beside `Smoothing`. The pad datum is normally taken
  only from a fix that clears a quality bar (≥6 satellites, hAcc ≤10 m); this
  turns that off so any 2D fix will do — useful on a bench, where the bar is a
  launch-site bar the receiver rarely clears.
  Confidence and policy are kept apart: a weak fix accepted with the gate off
  is **still drawn faded and still counted low-confidence**. Turning the gate
  off permits a datum; it does not make the fix accurate. It also does not move
  an existing datum — that is what `Set pad` is for.
- **Serial monitor in the page.** The footer only ever showed the latest line,
  so boot output and `g` replies scrolled past at 25 Hz and the only way to
  read them was to disconnect and open the Arduino Serial Monitor — which
  means giving up the port, and therefore the live view. The console is
  collapsed by default, excludes telemetry frames unless asked, preserves the
  blank lines the boot output uses as structure, and sticks to the bottom only
  when the reader is already there. Read-only: `c` and `h` would corrupt the
  stream the page is parsing, so there is no free-text field to fire them from.

### Fixed

- **The trajectory legend overlapped the stage hint.** Both are anchored to the
  bottom edge of the stage — the hint is absolutely positioned across its full
  width — so the legend text and the "close the Arduino Serial Monitor first"
  overlay drew straight through each other, and the legend got worse as it grew
  lines. The hint is now hidden on the trajectory tab (it is about connecting
  and streaming, not the path) and restored on the attitude tab, and the legend
  draws its own backing panel so the ground grid cannot muddy it either. The
  drag-to-orbit affordance is dropped on a canvas too narrow to hold it clear
  of the legend block — on a small screen the numbers matter more than the hint.

- **A missing `hAcc` blocked the pad datum forever.** The gate hard-required
  the field, contradicting the rule that appended fields are optional (§6.6).
  Any board on firmware older than that field could never establish a datum,
  and the only symptom was a **purely vertical trajectory** with nothing on
  screen explaining why. Where `hAcc` is absent the gate now falls back to
  satellite count alone.

### Test

`tools/checks` gained cases for all three: the gate as a policy toggle that
does not launder a weak fix, a legacy 14-field frame still datuming on
satellite count, and the console's filtering, blank-line handling and cap.

### Docs

`docs/images/viewer-attitude.png` refreshed to show the release as built — the
`Fix gate` toggle, the `ACCURACY` readout and the collapsed serial monitor.
Captions in the README and §6.7 updated to match its figures, since a caption
that misdescribes its own image is worse than none.

---

## [0.2.0] — 2026-09-09

### Added

**ADXL375 high-g accelerometer and SAM-M8Q GPS are wired onto the I²C bus and
driven by `rocket_diagnostics/`.** All four sensors specified in §3.1 are now
physically present on the flight computer.

- **High-g column** in the diagnostics table, plus a peak tracker and a rest
  check. Absent hardware reads `---` rather than a fabricated `0`.
- **GPS status** — fix type, satellite count, coordinates and MSL altitude —
  printed in the 5-second summary and on demand with a new `g` command.
  Distinguishes *never acquired* from *acquired and lost*, because those point
  at different faults (sky view versus antenna or power).
- **Config readback extended to both new parts**, applying the rule §4.3
  already imposes on the IMU: the ADXL375 output data rate is decoded from
  `BW_RATE`, and the GPS dynamic model and navigation rate are read back from
  the module. Both are printed at boot, so a write that silently failed shows
  up as a wrong *printed* value.
- **Graceful degradation.** Neither new part is fatal if absent — only the
  barometer and IMU halt the sketch, because every other displayed number is
  derived from them.
- CSV mode gained a `highg_g` column.

**High-g and GPS reach the viewer, and there is a trajectory view.**

- **Wire format extended** (§6.6) by *appending* six fields, so any parser
  reading only the first eight or nine is unaffected:
  `V,ax,ay,az,gx,gy,gz,alt,vel,millis,hg,fix,sats,lat,lon,hacc`.
  `hg` and `fix` use **−1** for "part not fitted" — deliberately distinct from
  a zero reading, since 0.00 g is legal in freefall, fix type 0 is a legal
  "no fix", and 0,0 is a real position in the Gulf of Guinea.
- **High-g and GPS readouts** in the viewer: magnitude and peak, fix type,
  satellite count, position, and distance from the pad.
- **Trajectory tab** — the flown path in 3D over a metric ground grid, with a
  drag-to-orbit camera that auto-frames the data. **Only altitude is
  measured.** Horizontal comes from the GPS, which is blind through the whole
  flight, so unlocked segments are drawn dashed and red with the horizontal
  frozen at the last fix — never interpolated. A smooth arc through that gap
  would be an invention.
- **Path sampling throttles on the board's clock**, not on arrival time. Both
  transports deliver in bursts; throttling on arrival collapses a burst into a
  single point and samples the path unevenly. This is the same argument that
  put `millis()` in the format in the first place.
- **Board command buttons** — `Zero baro`, `Gyro bias`, `Reset peaks`,
  `GPS status`. Serial-only, and hidden in network mode: SSE is one-way, so a
  page served by the ground station has no back-channel to the flight computer.
  `c` and `h` are deliberately not exposed — both corrupt the stream the page
  is reading. Zeroing and bias blocking the sketch for a second or more
  suppresses the staleness flag for the duration, so it does not cry outage
  about a pause the operator asked for.
- **Ground station producer** emits the same fourteen fields, including a
  synthetic GNSS that **drops lock from launch until a few seconds past
  apogee** and reacquires drifted downwind. Without that, the trajectory gap
  path would go untested until a real flight.

**GPS position is now qualified, not just reported.** Found on the bench: a
stationary board holding a **3D fix on 5 satellites** sat **238 m** from where
it first locked, with the fix type reading `3D` the whole time. Two separate
problems, one of them ours.

- **`hacc` carried in telemetry** — the receiver's own horizontal accuracy
  estimate, already present in the NAV-PVT message it sends anyway
  (`getHorizontalAccEst()`), so it costs nothing. Shown in the viewer and in
  the sketch's `g` output, which now also warns when satellites drop below 6.
  A position with no accuracy beside it cannot be argued with.
- **The pad datum is gated.** It was taken from the *first* locked fix — the
  worst one of any session, straight out of a cold start with the fewest
  satellites and the worst geometry. Every distance was then measured from it,
  and every later and better fix appeared to *move*. The datum is now accepted
  only from a fix the receiver vouches for (**≥ 6 satellites, `hAcc` ≤ 10 m**);
  until one arrives the display reads `no pad datum` instead of a fabricated
  distance from a bad origin.
- **`Set pad` button** re-datums on the next fix that clears the same bar, and
  discards points recorded against the old datum — they live in the old frame
  and would draw a step the vehicle never took.
- **Low-confidence fixes are drawn faded** rather than dropped or drawn at full
  strength. Dropping them would hide that the vehicle was somewhere; drawing
  them normally would overstate how well we know where.

Note the drift being *along one axis* was not a bug: with five satellites in
one patch of sky the error ellipsoid is long and thin, so a poor fix wanders in
a line rather than a blob.

**Telemetry staleness is now visible, end to end.** Previously "radio silent"
and "vehicle sitting perfectly still" produced identical displays — recorded in
the design document as a safety-relevant display defect rather than a nicety.

- **Viewer** (all three builds): a gap of more than 1.5 s — about 37 missed
  frames at 25 Hz — turns the status dot amber, counts the age of the last
  frame, and dims the numeric readouts. It runs independently of each
  transport's own error handling, because neither catches the case that
  matters: an SSE connection stays open while the ground station has nothing to
  forward, and a quiet serial port raises nothing.
- **Ground station**: `/stream` now stops emitting data frames when its source
  has been quiet for more than 1 s, sending SSE comment lines instead so the
  connection and its retry timer stay alive. This half is not optional. The
  stream previously re-sent the last frame forever, which would have made the
  viewer's timeout useless once the radio is real — frames would keep arriving
  on time, all saying the same thing. `/health` also reports `stale` and
  `source_age_ms`.
- New producers must call `tel.set_line()` rather than assigning `tel.latest`,
  so the freshness timestamp cannot be forgotten. The radio-hook example in the
  ground station README is updated accordingly.

**Photographs and screenshots added** under `docs/images/`, referenced from the
README, design document, hardware reference and status report: the viewer
running live on hardware, the diagnostics boot output, and two angles of the
breadboard bench stack. `.gitattributes` gained binary rules for image formats
— `* text=auto` would otherwise apply line-ending heuristics to them.

**All four sensors are now confirmed on hardware.** The boot output shows every
device answering on the bus and every configurable one reporting its settings
back: `CTRL1_XL = 0x50`, `CTRL2_G = 0x58`, `BW_RATE = 0xD` → 800 Hz, and the
GPS `airborne <1g  OK` at 5 Hz. §13.1 steps 5 and 6 are closed, with two
qualifications recorded below.

### Fixed

- **The high-g rest check called a healthy sensor faulty.** Its ±0.15 g
  tolerance was sized against quantisation (~20 counts per g) and ignored the
  much larger effect: the ADXL375's **zero-g offset is specified in whole g,
  not milli-g**, because it is a ±200 g part and the offset scales with the
  range. On this bench it reads **0.73 g at rest against the LSM6's 1.01 g** —
  to specification, not broken. The check now flags only readings outside
  ≈0.35–2.0 g, where the faults that matter live (a dead axis reads ≈0; an
  ADXL345 in the footprint reads ≈12× low), and reports anything inside that
  band as offset with the delta against the LSM6. Trimming the offset properly
  is an open item — it needs a per-axis calibration, since a magnitude check
  cannot separate offset from scale error.
- **Malformed telemetry lines counted twice.** `ingest()` incremented
  `tel.bad` and then returned false, and `handleLine()` incremented it again on
  the false — so the "Bad lines" readout showed double. Pre-existing; found by
  the headless viewer test.
- **High-g saturation would never have been detected.** The ADXL375 is 13-bit
  sign-extended into `int16`, so it saturates near ±4095 counts, not ±32767.
  Reusing the LSM6's `32000` threshold means the flag never fires and a clipped
  boost trace is reported as a valid measurement. The sketch now keeps a
  separate `HG_SAT_COUNT`, and the design document records the trap.
- **`applyImuConfig()` only warned on `CTRL2_G`.** A failed accelerometer
  register write passed silently — the exact class of fault the readback exists
  to catch. Both registers are now checked.
- **Column alignment walked on rounding.** `pad()` computed its width from the
  un-rounded value, so 9.996 at two decimals printed `10.00` where the digit
  count predicted four characters, shifting the row left by one. Width is now
  computed from the rounded value.
- **Gyro bias averaged partly duplicated samples.** The calibration loop
  delayed 4 ms against a 208 Hz (4.8 ms) gyro, so it re-read the same sample
  often enough to weight the average toward whichever readings happened to
  repeat. Now 6 ms, which keeps every sample independent — the point of
  averaging.

### Changed

- **The synthetic flight profile now clips its LSM6 fields to ±2 g** — the
  range that part is actually configured for — while the new `hg` field
  carries the true unclipped magnitude. The profile peaks at 6 g, so the two
  now disagree exactly as the real hardware would. The producer's own docstring
  already said the clipping "is real and the viewer should show it rather than
  hide it"; it was not previously implemented. This changes what the synthetic
  source displays for `|a|` in flight mode.
- Arduino sketches now live in per-sketch folders
  (`rocket_diagnostics/rocket_diagnostics.ino`). The Arduino IDE requires a
  `.ino` to sit in a directory of the same name; a bare sketch at the
  repository root prompts the IDE to relocate it, and two of them at the root
  cannot both be opened cleanly. `rocket_flight/` follows the same shape.
- Documentation updated across `README.md`, `avionics_documentation.md`
  (§4.4, §4.5, §6.7, §13.1, §13.2, §14), `hardware_reference.md`,
  `avionics_status_report.md` and the ground station README. The design
  document's closing note now names **four** silent failure modes on this
  platform rather than two — the GPS dynamic model and the ADXL375 saturation
  ceiling join the MS5611 and the gyro scale factor.

### Build and test

`arduino:mbed_rp2040:pico`, verified with `arduino-cli compile`:

| | before | after |
|---|---|---|
| Program storage | 112,536 B (5%) | **148,883 B (7%)** |
| Global variables | 43,996 B (16%) | **44,608 B (16%)** |

Both are exercised headlessly by `tools/checks/run_checks.py` (new; no
hardware, Node needed only for the viewer half):

- The `Telemetry` producer runs under CPython with a MicroPython shim over a
  full 40 s flight loop — field count, LSM6 clipping, high-g peak, GPS phase
  transitions, and the staleness timer.
- Each viewer build loads under Node with a stub DOM, is fed 1000 real frames
  from that producer, and is checked for parse errors, high-g and GPS
  extraction, trajectory point count, **horizontal frozen across every
  unlocked run**, altitude still varying while unlocked, **a 4-satellite
  ±42.5 m fix being refused as a pad datum**, `Set pad` waiting for a good fix
  before re-datuming, low-confidence fixes being flagged, a render pass in both
  stage modes, backward compatibility with a 9-field frame, and rejection of a
  malformed one.
- The synthetic source cold-starts realistically in bench mode — no fix for
  3 s, then 4 satellites at ±42 m converging to 9 at ±2.5 m — so the datum gate
  is exercised without hardware.

Nearly all of the +35.7 KB is the u-blox library; the RAM cost is +612 B.
Neither figure threatens the 112 KB flight buffer of §10.3, but the flight
firmware should be re-measured against it rather than assumed.

### Known, unresolved

- **The ADXL375's zero-g offset is untrimmed.** 0.73 g at rest against the
  LSM6's 1.01 g. Within specification, but it leaves the channel unusable for
  absolute magnitude near 1 g. Peaks and events — launch detect and burnout,
  its actual job — are unaffected.
- **The GPS has a fix but not a usable one.** Coordinates confirmed correct
  against a map, but tested only indoors: on 5 satellites the position wandered
  238 m. Needs open sky, where 10–15 satellites and single-digit metres are
  expected.
- **A phantom `0x7E` appears in the I²C scan.** Nothing in this design lives
  there and 0x78–0x7F is the reserved range, so it points at a marginal bus
  rather than a device — four sets of pull-ups in parallel on breadboard jumper
  leads being the prime suspect.

---

## [0.1.0] — 2026-09-08

Initial version.

### What exists

**Flight computer** — MS5611 barometer and MinIMU-9 v6 wired to a Raspberry Pi
Pico on the official Arduino Mbed OS core. `rocket_diagnostics/` runs on
hardware, reporting interpreted sensor values, 1σ altitude noise with a
suggested `APOGEE_DROP_M`, sensor ranges read back from the config registers,
gyro bias calibration, peak trackers and saturation flags.

**Ground segment** — a Pico W ground station in MicroPython, bringing up its own
Wi-Fi access point and serving a 3D attitude viewer over Server-Sent Events at
25 Hz. The viewer also runs over Web Serial when opened as a local file. Both
run on hardware; telemetry is synthetic.

**Documentation** — design document, hardware bench reference, airframe build
spec, bill of materials, status report, and a 3D assembly viewer.

### What does not exist

No high-g accelerometer, GPS, radio link, deployment hardware, arming
interlock, buzzer or airframe. `rocket_flight.ino` is not written, so no
deployment code exists and none has flown. The attitude filter runs ground-side
only, and the tilt inhibit is specified but not implemented.

### Known unreconciled

- §8.3 of the design document sizes the separation spring against **0.18 kg
  forward mass**, while `airframe_build_spec.md` targets **150–200 g dry mass
  for the whole rocket**. A 2 L PET bottle is ~50 g before fins, so these do
  not both hold.

---

[Unreleased]: https://github.com/rodpauloduran/MAARE-Avionics-System/compare/v0.3.2...HEAD
[0.3.2]: https://github.com/rodpauloduran/MAARE-Avionics-System/compare/v0.3.1...v0.3.2
[0.3.1]: https://github.com/rodpauloduran/MAARE-Avionics-System/compare/v0.3.0...v0.3.1
[0.3.0]: https://github.com/rodpauloduran/MAARE-Avionics-System/compare/v0.2.1...v0.3.0
[0.2.1]: https://github.com/rodpauloduran/MAARE-Avionics-System/compare/v0.2.0...v0.2.1
[0.2.0]: https://github.com/rodpauloduran/MAARE-Avionics-System/compare/v0.1.0...v0.2.0
[0.1.0]: https://github.com/rodpauloduran/MAARE-Avionics-System/releases/tag/v0.1.0
