rodpauloduran/MAARE-Avionics-System/(commit log)

2026-09-08 MAARE avionics system v0.1
    Initial version of the MAARE water rocket avionics system.
    WHAT EXISTS
    Flight computer — MS5611 barometer and Pololu MinIMU-9 v6 on a Raspberry
    Pi Pico, official Arduino Mbed OS core. rocket_diagnostics.ino runs on
    hardware, reporting interpreted sensor values, running 1-sigma altitude
    noise with a suggested APOGEE_DROP_M, sensor ranges read back from the
    config registers, gyro bias calibration, peak trackers and saturation
    flags.
    Ground segment — a Pico W ground station in MicroPython bringing up its
    own Wi-Fi access point and serving a 3D attitude viewer over Server-Sent
    Events at 25 Hz. The viewer also runs over Web Serial when opened as a
    local file, whi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
    [water_rocket_avionics_bom.xlsx]
2026-09-08 Move Arduino sketches into per-sketch folders (#2)
    The Arduino IDE requires a .ino to sit in a directory of the same name.
    A bare sketch at the repository root prompts the IDE to relocate it on
    open, and two of them at the root cannot both be opened cleanly - which
    would happen as soon as rocket_flight is added alongside.
    rocket_diagnostics.ino -> rocket_diagnostics/rocket_diagnostics.ino
    The convention is now documented in section 9.2 of the design document,
    so the flight firmware lands in rocket_flight/ rather than repeating
    this. Open items that call for that file now name its full path.
    References updated across the design document, hardware reference,
    status report, README and ch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
2026-09-08 v0.2 — high-g and GPS on the bus, trajectory view, telemetry staleness (#4)
    The ADXL375 and SAM-M8Q are wired onto the I2C bus and driven by
    rocket_diagnostics. All four sensors are now confirmed on hardware, with
    every configurable one reporting its settings back at boot.
    Sensors
    - ADXL375 high-g and SAM-M8Q GPS integrated, with config readback extended
    to both: data rate decoded from BW_RATE, GPS dynamic model and nav rate
    read back from the module.
    - Per-part saturation ceilings. The ADXL375 is 13-bit sign-extended into
    int16, so it clips near +/-4095, not +/-32767 — reusing the LSM6 threshold
    meant high-g clipping could never fire.
    - Missing parts degrade to "---" / "not fit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
    [main.py, rocket_diagnostics.ino]
2026-09-09 v0.2.1 — fix-gate toggle, in-page serial monitor, legend overlap (#5)
    Added
    - `Fix gate` toggle beside `Smoothing`. The pad datum is normally taken only
    from a fix clearing a quality bar (>=6 satellites, hAcc <=10 m); this turns
    that off so any 2D fix will do, which is what a bench needs since the bar is
    a launch-site bar.
    Confidence and policy are kept apart, as two predicates rather than one:
    confident() judges the FIX and never follows the toggle, so a weak fix
    accepted with the gate off still renders faded and still counts as
    low-confidence. trusted() is policy. Switching the gate off permits a datum;
    it does not make the fix accurate, and the display must not imply it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
2026-09-09 Refresh the attitude viewer screenshot for v0.2.1 (#6)
    The committed image predated this release, so it showed neither the `Fix gate`
    toggle, the `ACCURACY` readout, nor the serial monitor. Replaced with a capture
    of the release as built.
    Captions in the README and §6.7 updated to match the new figures — tilt 0.44°,
    high-g peak 2.41 g, 25 Hz across 3873 frames, and `hg = 0.55` in the raw
    telemetry line. A caption that misdescribes its own image is worse than none.
    Claude-Session: https://claude.ai/code/session_01UqmvUCN7NhCAhsydkNNnvk
2026-09-11 v0.3 — servo latch and trigger harness, buzzer, servo smoke test (#7)
    - MG90D servo latch on GP6, driven through the Servo library. `!`-prefixed
    line commands carry the values a single character cannot: !arm, !safe,
    !fire, !latch, !us <n>, !pos <a> <b>, !srv, !hb. The single-character
    commands are untouched and still dispatch on arrival.
    - Deployment test harness in the viewer: arm/safe, manual fire, re-latch,
    endpoint calibration, and an editable condition list (altitude, drop below
    peak, vertical velocity, tilt, |a|, high-g, rate, satellites, time since
    arm) with all/any matching and a sustain window. Export emits the tuned
    thresholds as C constants.
    - LS3040 buzzer o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
    [main.py, rocket_diagnostics.ino, servo_smoke.ino]
2026-09-11 Refresh photographs for v0.3 and fix the captions they invalidated (#8)
    New bench photos, boot output and attitude screenshot, plus a new trajectory
    screenshot. Every caption quoted figures from the image it replaced, so all of
    them are rewritten to match. bench-stack-2 now shows the servo and buzzer, so it
    moves from the address map to the latch section and bench-stack-1 takes its
    place.
    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
2026-09-11 v0.3.1 — wired link as a radio stand-in, and full control from a phone (#9)
    - Wired UART link between the flight computer and the Pico W ground station,
    standing in for the radio until the antenna pigtails arrive. Telemetry goes
    down GP0 every tick; the station reads it into the same producer slot the
    radio will use.
    - Explicit telemetry sources on the station (uart by default, or a synthetic
    profile) with NO fallback from a dead wire to synthetic data. In uart mode
    the synthetic model does not run, so a quiet wire goes stale.
    - Frame validation and line reassembly on the station: partial lines, board
    text, undecodable bytes and wrong field counts never reach a browser.
    -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
    [main.py, rocket_diagnostics.ino]
2026-09-13 v0.3.2 — every frame forwarded, and three bench items closed (#10)
    The ground station resent the latest frame on its own timer, capping delivery
    at its loop rate: a 25 Hz board arrived at 23 Hz and the frames in between
    were never sent. Frames now carry sequence numbers and each browser is sent
    each one once, so the delivered rate is the producer's. The rule moved into a
    StreamCursor so a test can drive it -- the bug survived because serve_stream
    had nothing to call.
    Also: the 5 s GPS summary no longer floods a phone's console (it went through
    the teed printer; the caller now names the destination), the stage label no
    longer runs under the tabs on a phone, and deployment condition rows la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
    [main.py, rocket_diagnostics.ino]
